Riley-Peterson/Liquid-Avionics/README.md

# Liquid-Avionics
Avionics system for liquid rocket
