Riley-Peterson/Liquid-Avionics/Hardware/Liq_Controller/Liq_Controller.step

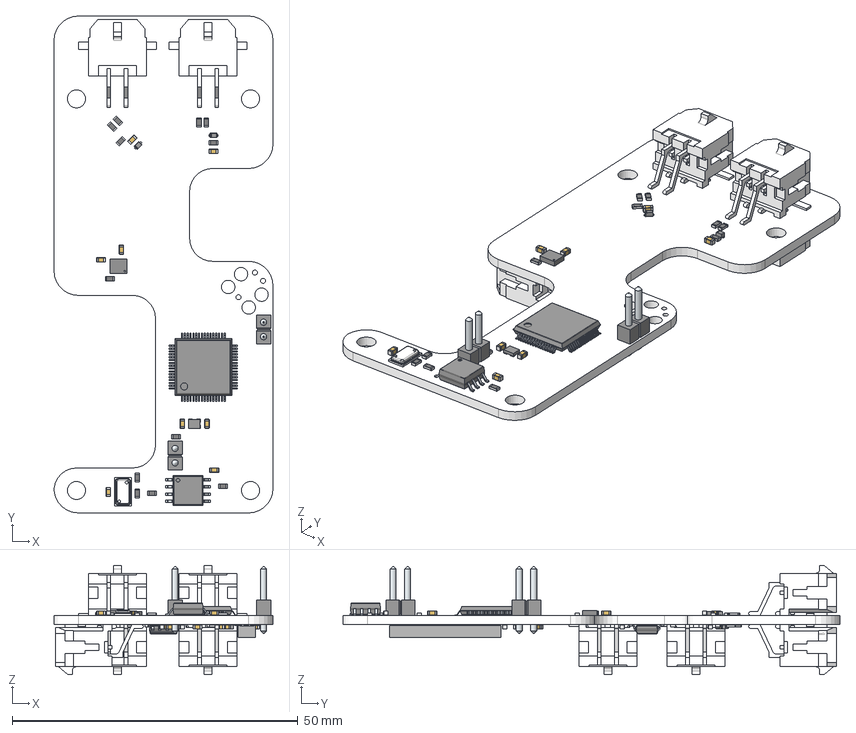
[picture p1: CAD file, 2026-10-20]
Hardware/Liq_Controller/Liq_Controller.step
38.4 x 87.0 x 19.1 mm
