Riley-Peterson/Liquid-Avionics/Hardware/Liq_Power/Liq_Power.step

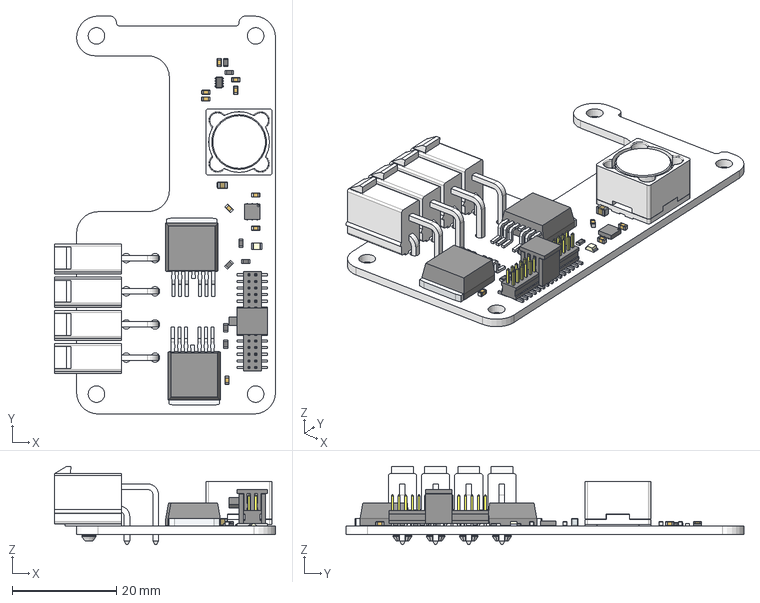
[picture p2: CAD file, 2026-10-20]
Hardware/Liq_Power/Liq_Power.step
42.3 x 76.2 x 15.0 mm
