Riley-Peterson/Liquid-Avionics/(list of files, drawings)

Other design files:
Hardware/Liq_Controller/Liq_Controller.PcbDoc
Hardware/Liq_Controller/Liq_Controller.PrjPcb
Hardware/Liq_Controller/Liq_Controller.SchDoc
Hardware/Liq_Controller/Microcontroller.SchDoc
Hardware/Liq_Controller/Peripherals.SchDoc
Hardware/Liq_Power/Liq_Power.PcbDoc
Hardware/Liq_Power/Liq_Power.PrjPcb
Hardware/Liq_Power/Liq_Power.SchDoc
