Riley-Peterson/Liquid-Avionics/Software/Software.ioc

Mcu.UserName=STM32F446RETx
PA0-WKUP.GPIO_Label=Camera2_OUT
PA0-WKUP.Signal=GPIO_Output
PA1.GPIO_Label=Camera2_IS
PA1.Signal=ADCx_IN1
PA11.Signal=CAN1_RX
PA12.Signal=CAN1_TX
PA13.Signal=SYS_JTMS-SWDIO
PA14.Signal=SYS_JTCK-SWCLK
PA15.GPIO_Label=IMU_Int1
PA15.Signal=GPXTI15
PA2.GPIO_Label=Camera1_IS
PA2.Signal=ADCx_IN2
PA5.Signal=SPI1_SCK
PA6.Signal=SPI1_MISO
PA7.Signal=SPI1_MOSI
PB0.Signal=ADCx_IN8
PB1.Signal=ADCx_IN9
PB10.Signal=SPI2_SCK
PB2.GPIO_Label=SEL
PB2.Signal=GPIO_Input
PB6.Signal=I2C1_SCL
PB7.Signal=I2C1_SDA
PC1.Signal=SPI2_MOSI
PC10.GPIO_Label=IMU_CS
PC10.Signal=GPIO_Output
PC11.GPIO_Label=IMU_Int2
PC11.Signal=GPXTI11
PC13.GPIO_Label=Camera1_OUT
PC13.Signal=GPIO_Output
PC2.Signal=SPI2_MISO
PC3.GPIO_Label=Flash_CS
PC3.Signal=GPIO_Output
PC4.Signal=ADCx_IN14
PC5.Signal=ADCx_IN15
PC6.Signal=USART6_TX
PC7.Signal=USART6_RX
PH0-OSC_IN.Signal=RCC_OSC_IN
PH1-OSC_OUT.Signal=RCC_OSC_OUT
