Riley-Peterson/Liquid-Avionics/(commit log)

2026-09-26 Finish routing power board
    [Liq_Power.PcbDoc, Liq_Power.PrjPcb, Liq_Power.SchDoc, Liq_Power.step]
2026-09-26 Update controller schematic
    [Liq_Controller.PcbDoc, Liq_Controller.PrjPcb, Liq_Controller.SchDoc, Liq_Controller.step, Microcontroller.SchDoc, Peripherals.SchDoc]
2026-09-30 Added labels
    [Liq_Power.PcbDoc]
2026-09-30 Update pinouts
    [Liq_Controller.SchDoc, Microcontroller.SchDoc, Peripherals.SchDoc]
2026-09-30 Finish routing
    [Liq_Controller.PcbDoc]
2026-10-06 Create gerbers
    [Liq_Controller.PcbDoc, Liq_Power.PcbDoc]
2026-10-20 Update BOM and .STEP
2026-10-30 Add all drivers and test script
2026-10-30 Keep executor awake so SWD can attach after power-up
    The ST-Link can't open a new SWD connection while embassy's executor
    idles in WFE (DP WAIT), even with DBGMCU_CR set. Add board::keep_awake,
    an always-pending task, and spawn it in diag.
2026-10-30 Stream PT1-PT4 over CAN, one frame per PT
    Add can_map with the J1939 IDs from the Liquid AV CAN Map doc (rev B)
    and a pt_can binary that sends each PT on its own PGN (0xFF21-0xFF24)
    at 100 Hz with a shared sample counter.
